kiu/rfm12square/media/rfm12square-parts.jpg

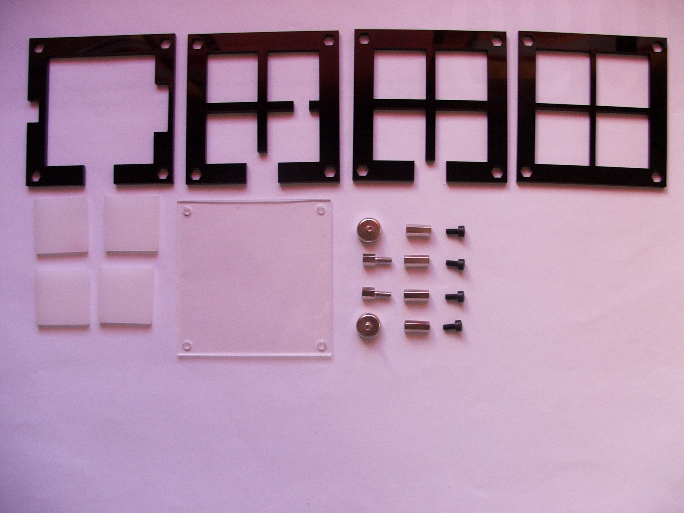
media/rfm12square-parts.jpg
