kiu/rfm12square/media/rfm12square-rgbw2.jpg

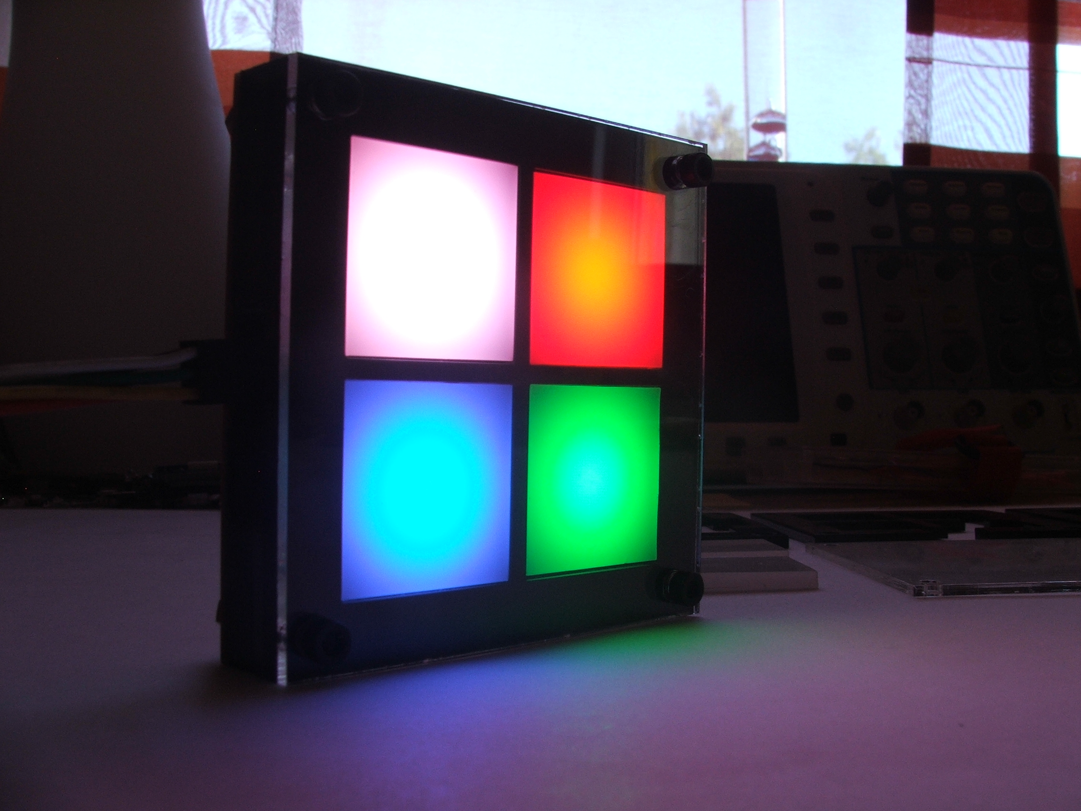
media/rfm12square-rgbw2.jpg
