kiu/rfm12square/pcb/gerber/readme.txt

Order: 54018

QTY: 10
Layer: 2
PCB Thickness: 1.6mm
PCB Dimension: 100x100mm (75x75mm)
PCB Color: red
Surface: Hasl
E-Test: 50%
