kiu/rfm12square/media/rfm12square-case1.jpg

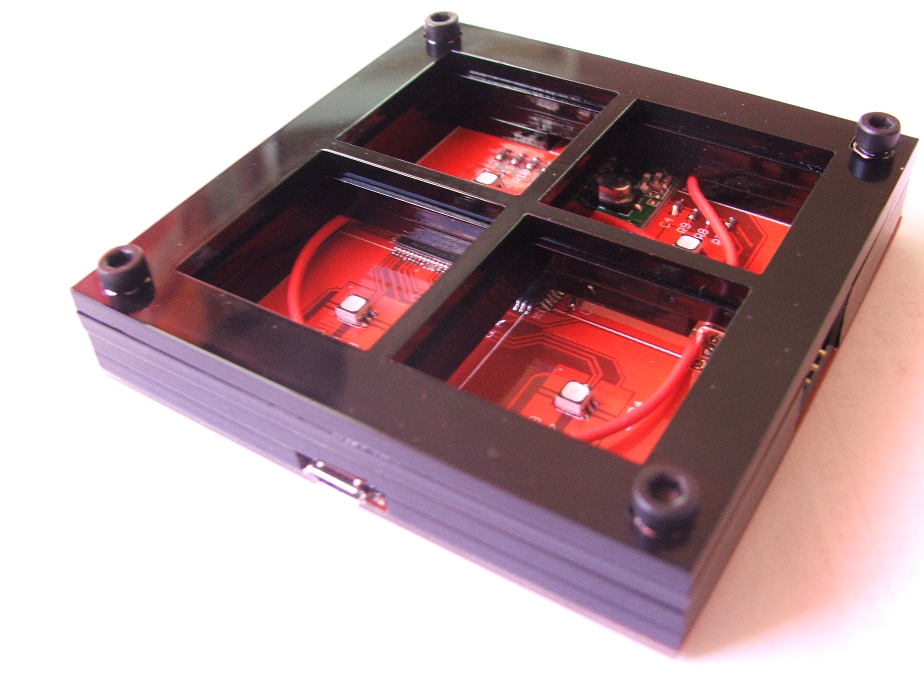
media/rfm12square-case1.jpg
