kiu/rfm12square/media/rfm12square-case2.jpg

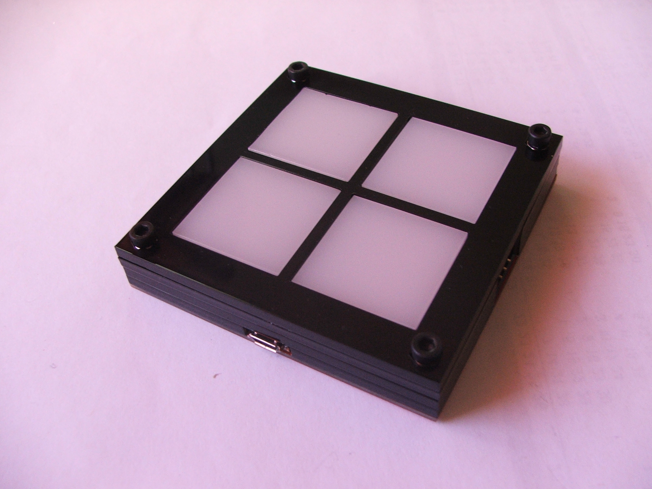
media/rfm12square-case2.jpg
