kiu/rfm12square/media/rfm12square-pcb-populated.jpg

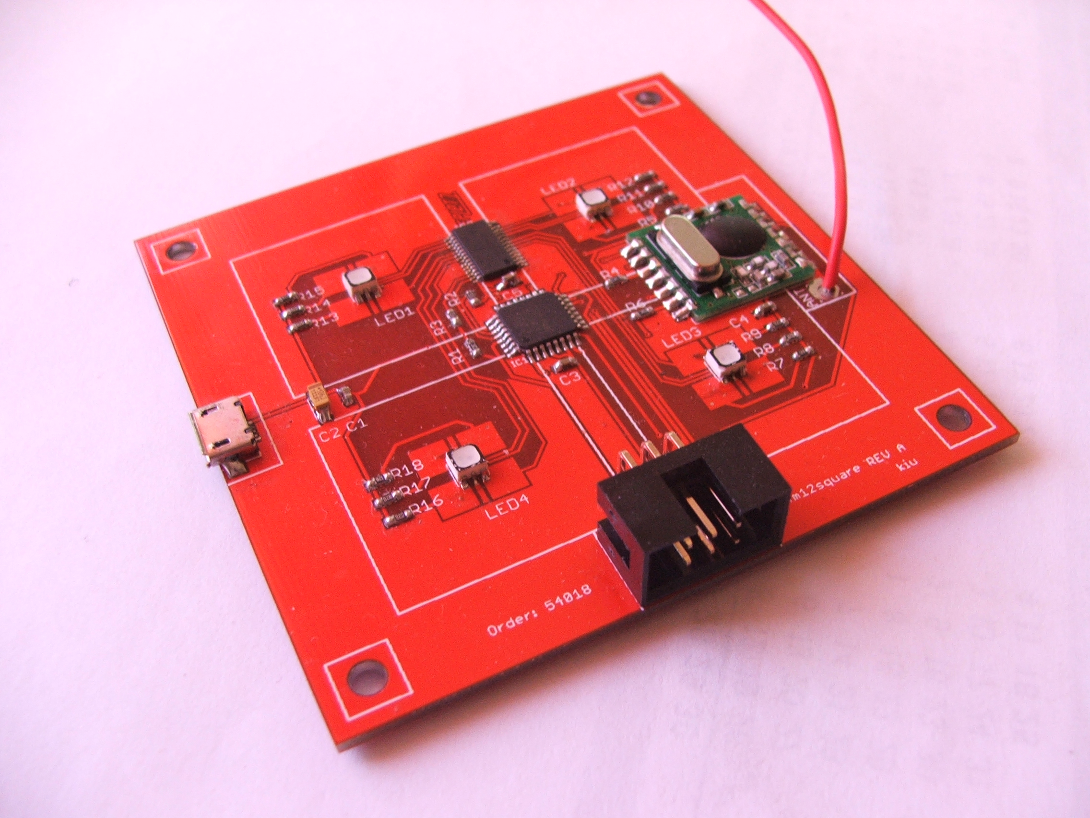
media/rfm12square-pcb-populated.jpg
