kiu/rfm12square/media/rfm12square-pcb.jpg

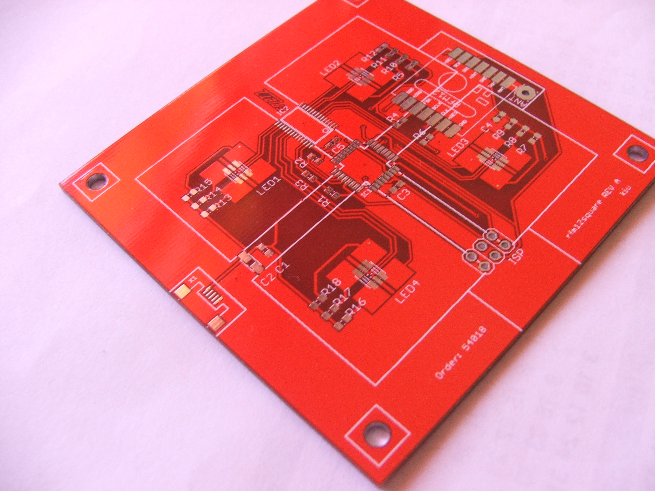
media/rfm12square-pcb.jpg
