kiu/rfm12square/media/rfm12square-rgbw1.jpg

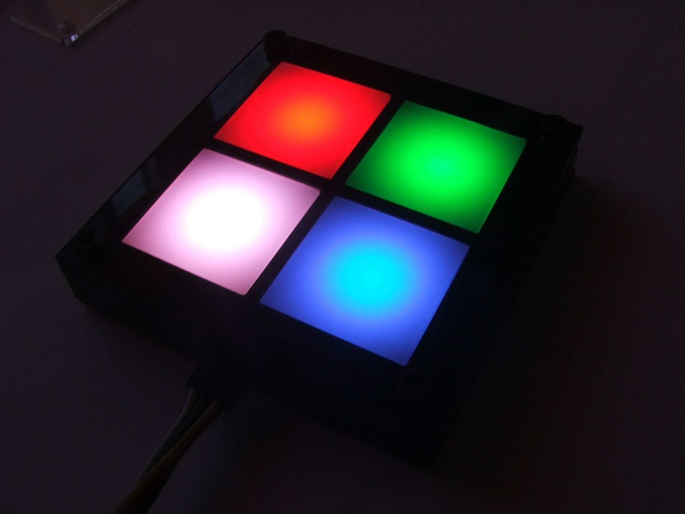
media/rfm12square-rgbw1.jpg
