kiu/rfm12square/media/rfm12square-yb1.jpg

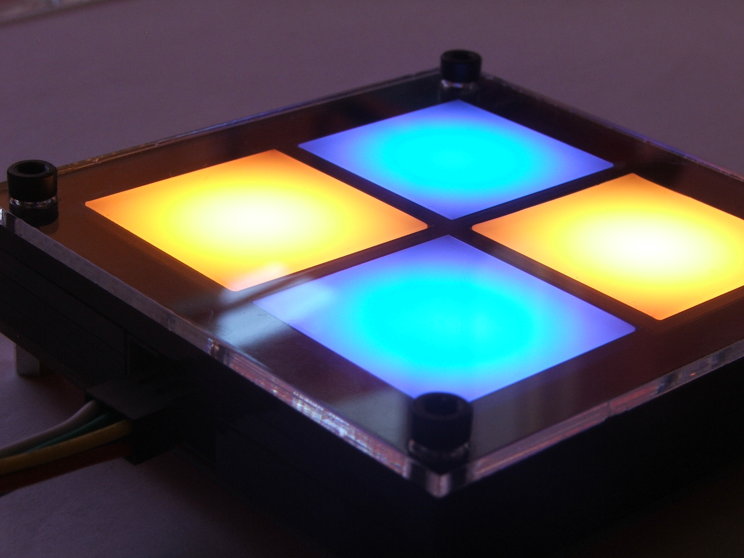
media/rfm12square-yb1.jpg
