kiu/rfm12square/media/rfm12square-yb2.jpg

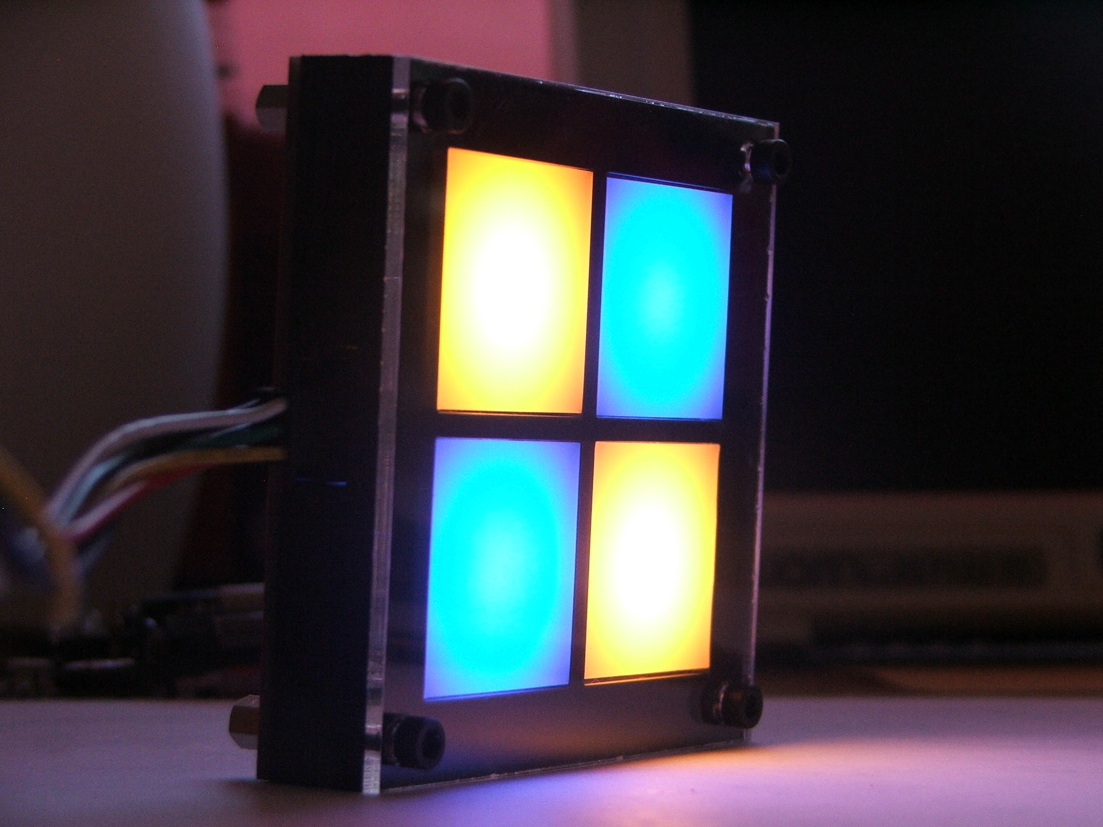
media/rfm12square-yb2.jpg
