kiu/rfm12square/bom.ods

Ordered | Description | Qty | Price | Price (sum) | Id | Link
x | LED RGB | 40 | 0.99 € | 39.60 € | LRTB G6TG | http://www.reichelt.de
x | Wannenstecker, 6-polig, gewinkelt | 10 | 0.16 € | 1.60 € | WSL 6W | http://www.reichelt.de
x | Shipping | 1 | 5.60 € | 5.60 € | - | http://www.reichelt.de
x | Micro USB | 10 | 1.13 € | 11.25 € | ESB227110100Z | http://www.tme.eu
x | SMD ATMega8-16 TQFP-32 | 10 | 1.82 € | 18.20 € | ATMEGA8-16AU | http://www.tme.eu
x | RFM12 | 10 | 4.58 € | 45.80 € | RFM12-433-S1 | http://www.tme.eu
x | (40x) SMD 100nF | 100 | 0.01 € | 0.69 € | 0603YC104KAT2A | http://www.tme.eu
x | (25x) SMD Tantal 10uF A | 25 | 0.10 € | 2.50 € | TAJA106K006R | http://www.tme.eu
x | (40x) SMD 82 (90) | 100 | 0.01 € | 0.90 € | SMD0603-82R-1% | http://www.tme.eu
x | (80x) SMD 130 (145) | 100 | 0.01 € | 0.90 € | SMD0603-130R-1% | http://www.tme.eu
x | (20x) SMD 4k7 | 100 | 0.01 € | 0.87 € | SMD0603-4K7-1% | http://www.tme.eu
x | (30x) SMD 10k | 100 | 0.01 € | 0.87 € | SMD0603-10K-1% | http://www.tme.eu
x | (10x) SMD 100k | 100 | 0.01 € | 0.87 € | SMD0603-100K-1% | http://www.tme.eu
x | Distanzhülsen, Metall, M3, 12mm | 40 | 0.19 € | 7.56 € | TFF-M3X12/DR113 | http://www.tme.eu
x | Distanzhülsen, Metall, M3, 5mm | 20 | 0.10 € | 1.90 € | TFM-M3X5/DR213 | http://www.tme.eu
x | Shipping | 1 | 5.90 € | 5.90 € | - | http://www.tme.eu
x | PCA9635PW | 10 | 2.71 € | 27.10 € | 1854073 | http://de.farnell.com
x | Shipping | 1 | 7.95 € | 7.95 € | - | http://de.farnell.com
x | 50x (40) DIN 912 A2 M3X6 SB | 1 | 4.99 € | 4.99 € | 912236SB | http://www.screwsandmore.de
x | Shipping | 1 | 4.50 € | 4.50 € | - | http://www.screwsandmore.de
x | Topfmagnet M3 | 20 | 1.24 € | 24.80 € | BMA-12-3 | http://www.magnetkontor.de
x | Shipping | 1 | 5.50 € | 5.50 € | - | http://www.magnetkontor.de
x | 360x240x3 9H01 | 4 | - | - | - | http://www.plexihandel.de
x | 360x240x2 trans | 1 | - | - | - | http://www.plexihandel.de
x | 360x240x3 WN770 | 1 | - | - | - | http://www.plexihandel.de
x | Sum | 1 | 31.80 € | 31.80 € | - | http://www.plexihandel.de
x | Lasertime | 1 | 30.00 € | 30.00 € | - | http://muc.ccc.de
x | PCB | 1 | 29.00 € | 29.00 € | - | http://www.seeedstudio.com
x | Shipping | 1 | 0.00 € | 0.00 € | - | http://www.seeedstudio.com
 |  |  |  | SUM
 |  |  |  | 310.65 € | for 10 pcs
