kiu/rfm12square/mech/rfm12square-single.dxf

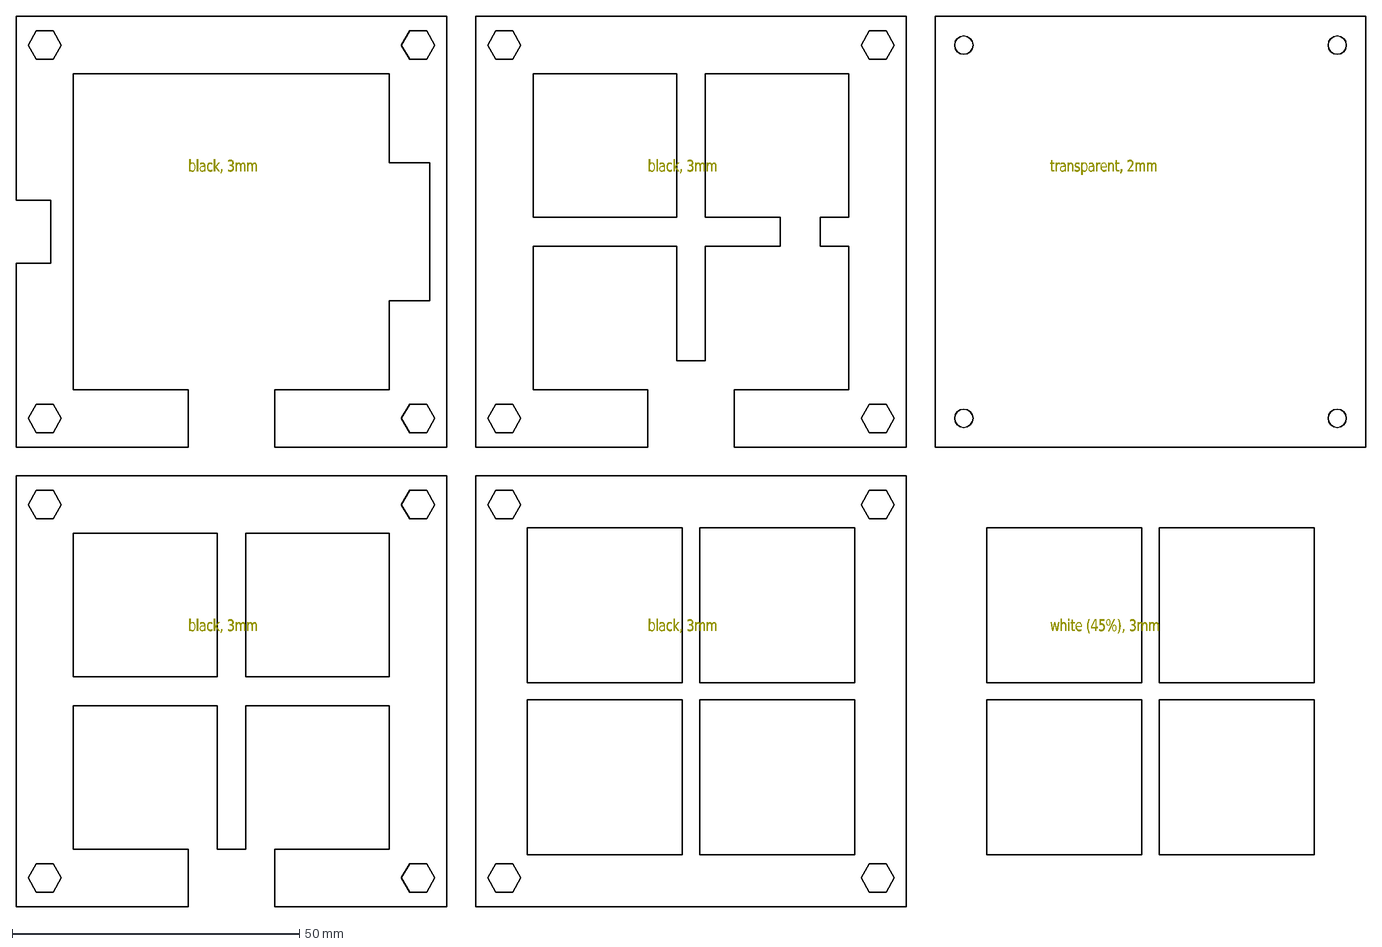
[picture p10: CAD file, 2012-08-18]
mech/rfm12square-single.dxf
black,\~3mm
white\~(45%),\~3mm
transparent,\~2mm
