kiu/rfm12square/pcb/rfm12square.brd

## EAGLE design pcb/rfm12square.brd (2012-08-09)

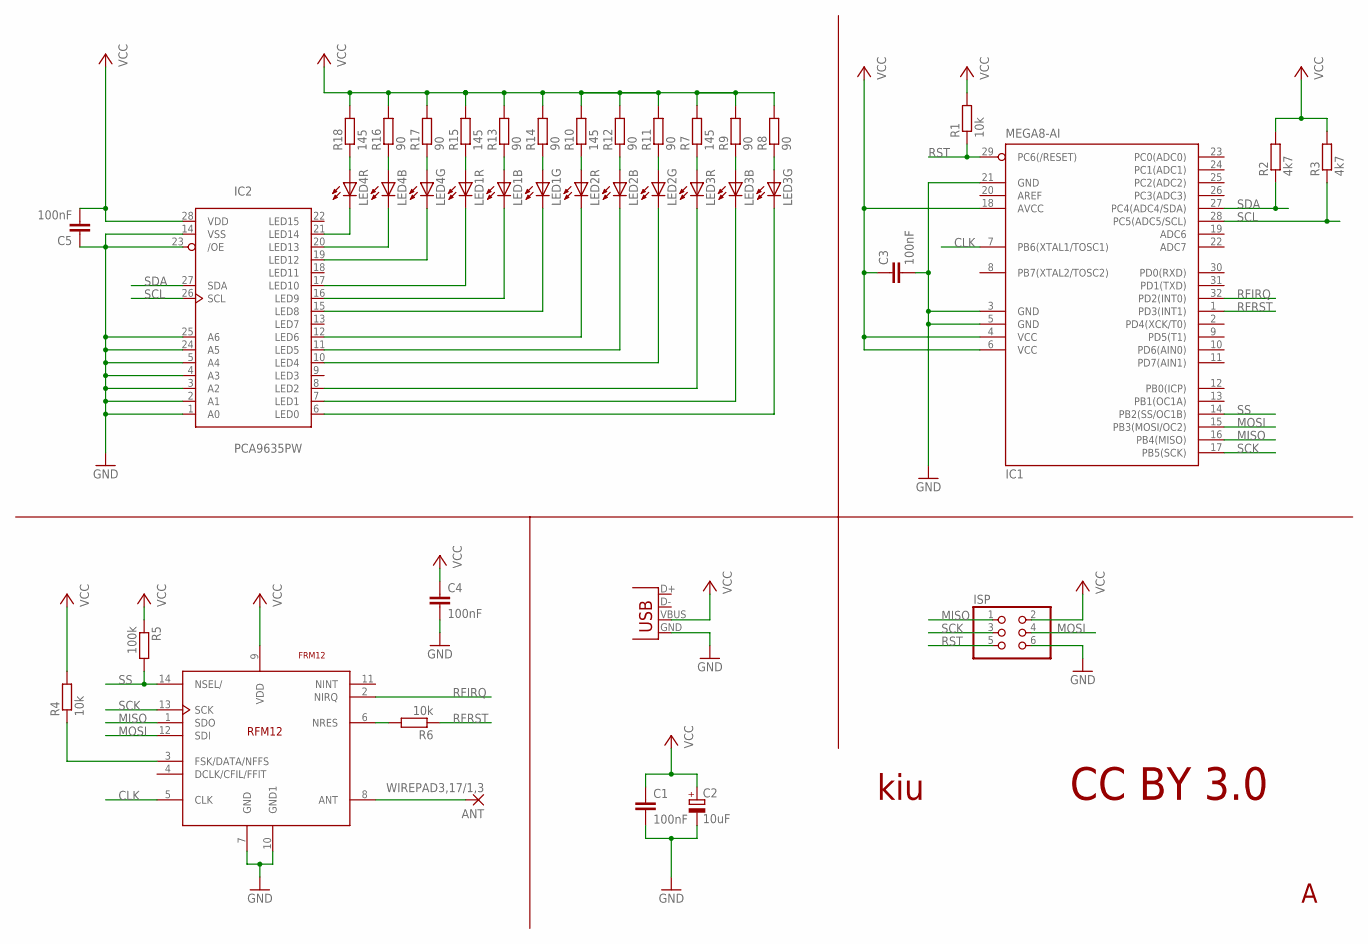
[picture p11: schematic rfm12square.sch]

Parts:
ANT: WIREPAD3,17/1,3; 3,17/1,3
C1, C3, C4, C5: 100nF; C0603
C2: 10uF; CT3216
IC1: MEGA8-AI; TQFP32-08
IC2: PCA9635PW; TSSOP28
ISP: PINHD-2X3; 2X03
LED1, LED2, LED3, LED4: MULTILED_LRTB_G6TG; P-LCC-6_TOPLED
R1, R4, R6: 10k; R0603
R2, R3: 4k7; R0603
R5: 100k; R0603
R7, R10, R15, R18: 145; R0603
R8, R9, R11, R12, R13, R14, R16, R17: 90; R0603
U$1: FRM12; RFM12
X1: USB-MICROB

Connections:
CLK: IC1.7 (PB6(XTAL1/TOSC1)), U$1.5 (CLK)
GND: C1.2, C2.-, C3.2, C4.2, C5.1, IC1.3 (GND), IC1.5 (GND), IC1.21 (GND), IC2.1 (A0), IC2.2 (A1), IC2.3 (A2), IC2.4 (A3), IC2.5 (A4), IC2.14 (VSS), IC2.23 (/OE), IC2.24 (A5), IC2.25 (A6), ISP.6, U$1.7 (GND), U$1.10 (GND1), X1.GND
MISO: IC1.16 (PB4(MISO)), ISP.1, U$1.1 (SDO)
MOSI: IC1.15 (PB3(MOSI/OC2)), ISP.4, U$1.12 (SDI)
unnamed: LED4.A2 (A), R17.1
unnamed: LED1.A2 (A), R14.1
unnamed: LED4.A3 (A), R16.1
unnamed: LED4.A1 (A), R18.1
unnamed: LED1.A3 (A), R13.1
unnamed: IC2.6 (LED0), LED3.C2 (C)
unnamed: IC2.7 (LED1), LED3.C3 (C)
unnamed: IC2.8 (LED2), LED3.C1 (C)
unnamed: IC2.10 (LED4), LED2.C2 (C)
unnamed: IC2.11 (LED5), LED2.C3 (C)
unnamed: IC2.12 (LED6), LED2.C1 (C)
unnamed: IC2.15 (LED8), LED1.C2 (C)
unnamed: R4.1, U$1.3 (FSK/DATA/NFFS)
unnamed: R6.2, U$1.6 (NRES)
unnamed: LED1.A1 (A), R15.1
unnamed: ANT.1, U$1.8 (ANT)
unnamed: IC2.16 (LED9), LED1.C3 (C)
unnamed: IC2.17 (LED10), LED1.C1 (C)
unnamed: LED2.A3 (A), R12.1
unnamed: IC2.19 (LED12), LED4.C2 (C)
unnamed: IC2.20 (LED13), LED4.C3 (C)
unnamed: IC2.21 (LED14), LED4.C1 (C)
unnamed: LED2.A2 (A), R11.1
unnamed: LED2.A1 (A), R10.1
unnamed: LED3.A1 (A), R7.1
unnamed: LED3.A3 (A), R9.1
unnamed: LED3.A2 (A), R8.1
RFIRQ: IC1.32 (PD2(INT0)), U$1.2 (NIRQ)
RFRST: IC1.1 (PD3(INT1)), R6.1
RST: IC1.29 (PC6(/RESET)), ISP.5, R1.1
SCK: IC1.17 (PB5(SCK)), ISP.3, U$1.13 (SCK)
SCL: IC1.28 (PC5(ADC5/SCL)), IC2.26 (SCL), R3.1
SDA: IC1.27 (PC4(ADC4/SDA)), IC2.27 (SDA), R2.1
SS: IC1.14 (PB2(SS/OC1B)), R5.2, U$1.14 (NSEL/)
VCC: C1.1, C2.+, C3.1, C4.1, C5.2, IC1.4 (VCC), IC1.6 (VCC), IC1.18 (AVCC), IC2.28 (VDD), ISP.2, R1.2, R2.2, R3.2, R4.2, R5.1, R7.2, R8.2, R9.2, R10.2, R11.2, R12.2, R13.2, R14.2, R15.2, R16.2, R17.2, R18.2, U$1.9 (VDD), X1.VBUS

Notes on the sheet:
CC BY 3.0
kiu

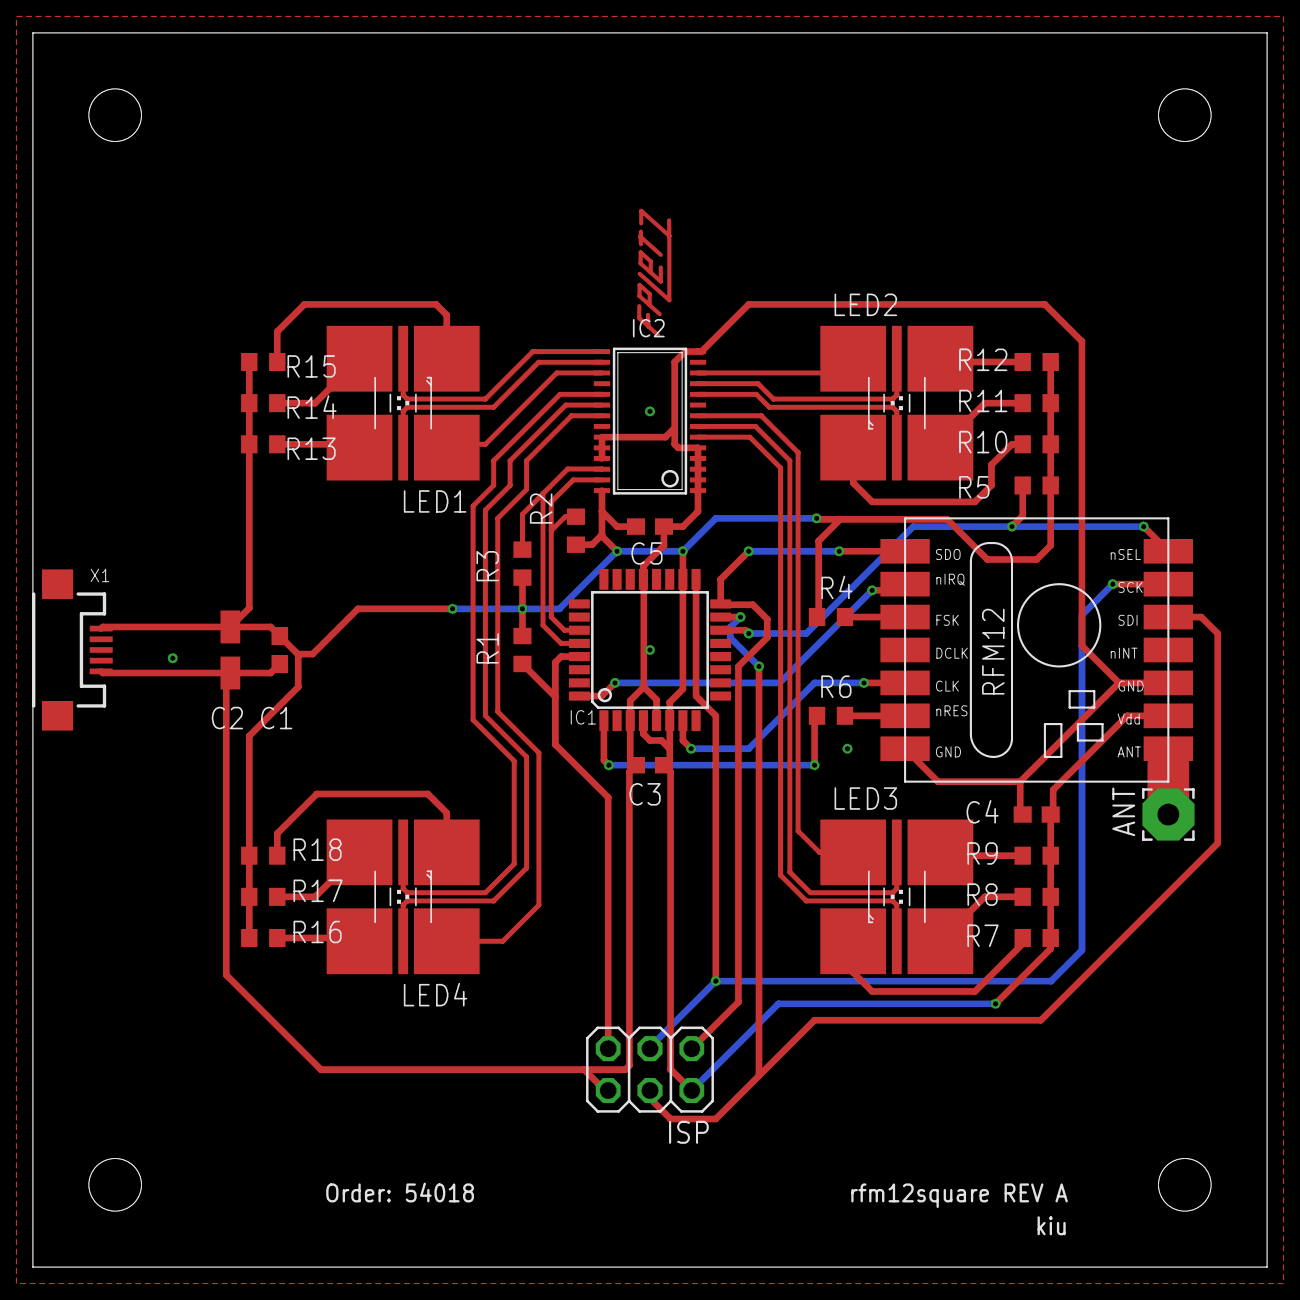
[picture p12: board rfm12square.brd from above]

Board: 2 copper layers, 75.0 x 75.0 mm, 33 parts (0 on the bottom side), 39 nets.
