kiu/rfm12square/firmware/rfm12square.h

#ifndef RFM12SQUARE_H
#define RFM12SQUARE_H

#define F_CPU 		8000000UL
#define DEVPWM 		0x00
#define RF_TIMEOUT	60

#define ADDRESS		0x20

#define TIMEOUT_SECONDS	150
#define TIMEOUT_COLOR 	0x0000FF
#define TIMEOUT_BLINK 	0x01

//#define ORIENTATION_USB_LEFT
//#define ORIENTATION_USB_TOP
#define ORIENTATION_USB_RIGHT
//#define ORIENTATION_USB_BOTTOM

#endif
