kiu/rfm12square/(commit log)

2012-08-18 Adding BOM
    [bom.ods]
2012-08-18 Adding mechanical files
    [rfm12square-single.dxf]
2012-09-07 Resetting RFM12 if no update was received on any LED after RF_TIMEOUT
    [rfm12square.c, rfm12square.h]
